amirhossein-p/Wireless_data_logger/PLC/README.md

## Wireless temperature data logger
### PLC code
PLC code for OMRON CP1H device. HMI code for OMRON NS5 device.

Works as a third-party for the data logger system. Full communication between the PLC and transceiver is provided.
