amirhossein-p/Wireless_data_logger/DL_v3/README.md

## Wireless temperature data logger
### Data logger code
Source code for data logger, written in C, for ATmega8a.
