amirhossein-p/Wireless_data_logger/TR_v3/README.md

## Wireless temperature data logger
### Transceiver code
Source code for Transceiver, written in C, for ATmega16.
