amirhossein-p/Wireless_data_logger/media/Intf1.PNG

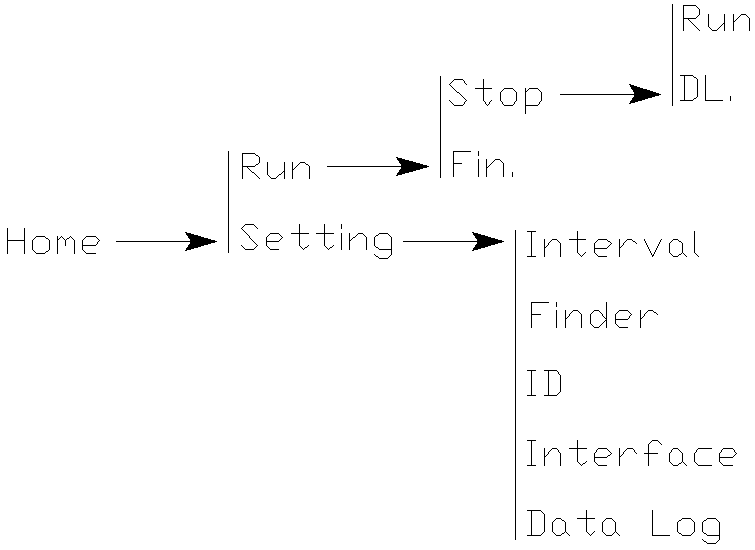
media/Intf1.PNG
