amirhossein-p/Wireless_data_logger/media/sign.png

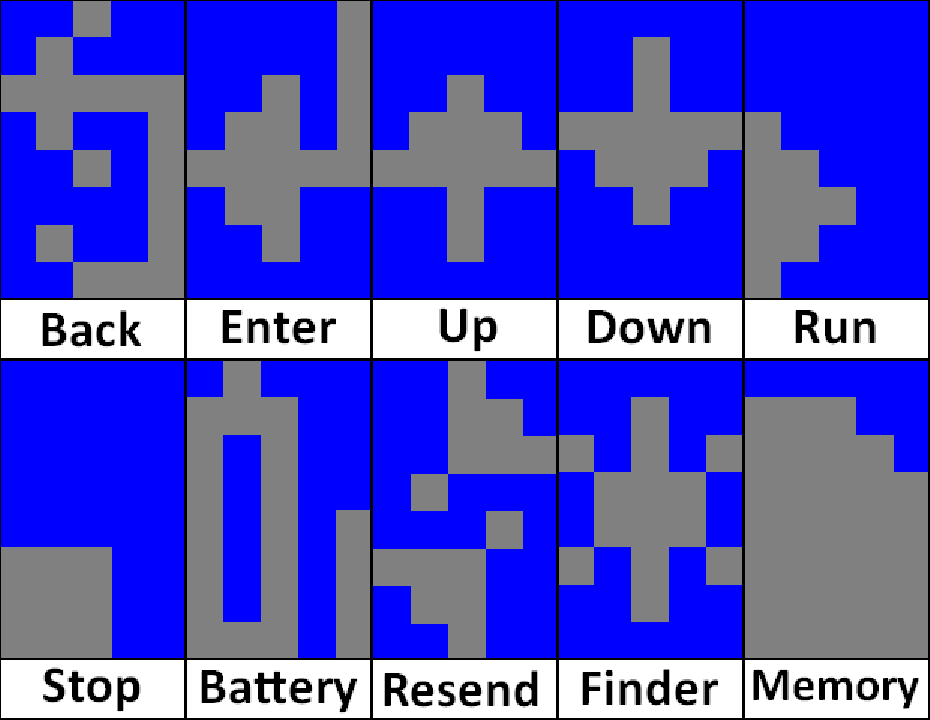
media/sign.png
